Fibela/Mini-Sumo/Mini-Sumo/README.md

# Mini-Sumo
Lista de materiales - código fuente - circuito - planos y diseño
