Fibela/Mini-Sumo/cad/vistas/MiniSumo_Chasis_vistas.png

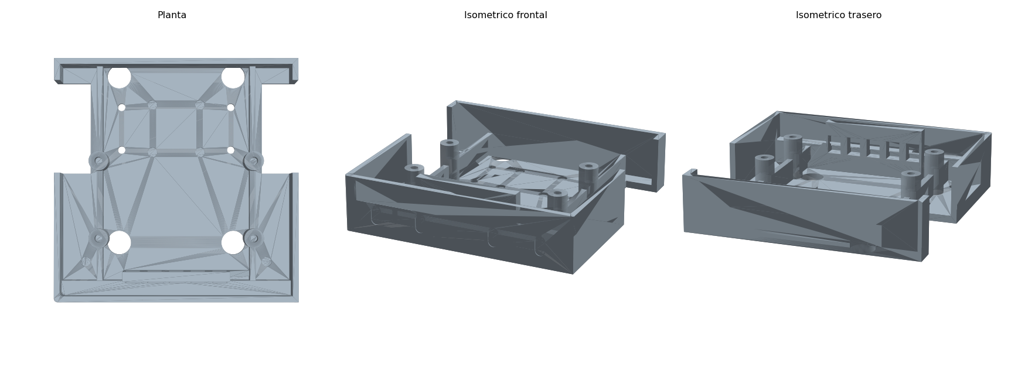
cad/vistas/MiniSumo_Chasis_vistas.png
