Fibela/Mini-Sumo/cad/vistas/MiniSumo_Cuna_Patin_vistas.png

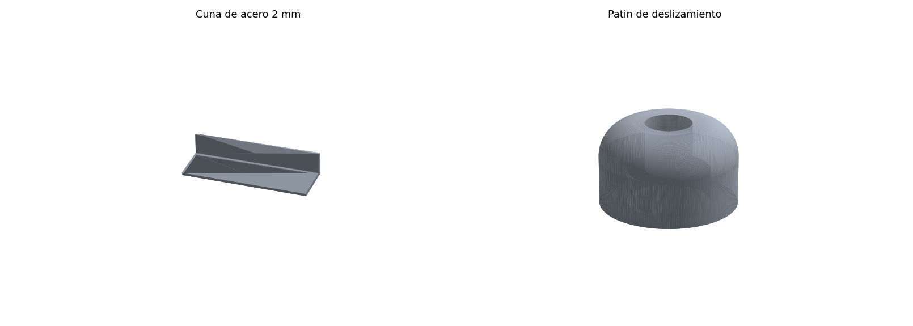
cad/vistas/MiniSumo_Cuna_Patin_vistas.png
