Fibela/Mini-Sumo/Mini-Sumo/lista-materiales.txt

Lista de materiales Sujeto a cambios

1° Arduino Nano ó ESP 32
2° LLantas de silicon(Fabricación propia) - Diametro 35 y 12 de ancho
3°  Puente H - L298N
4° Jumpers (x indefinido)
5° Sensores IR (x1) dedicado para bordes de dojo color blanco sustituyendo a los de linea por lo mientras
6° Batería LiPo 2S 850 mAh (x1)
7° Sensor de línea QRE1113 analógico (x4)
8° Motor D20 (x4)
9°  Cuña de acero 1mm 
10° sin Lastre
11° 5 sensores ToF VL53L1X
12° Display QLED 0.96 SSD1306 12C
