Fibela/Mini-Sumo/_revisar/MiniSumo_Chasis_2026-10-07.SLDPRT

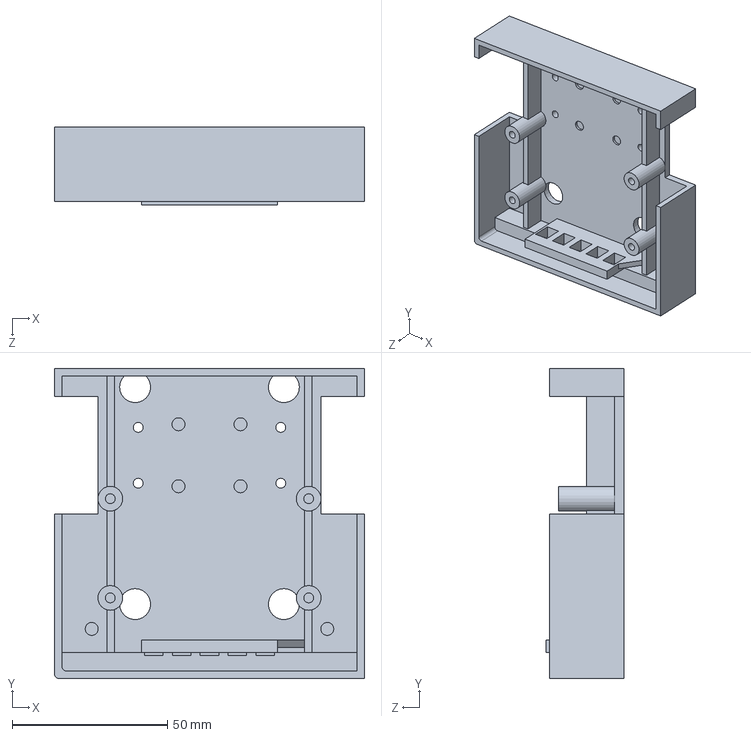
[picture p6: CAD file, 2026-10-07]
_revisar/MiniSumo_Chasis_2026-10-07.SLDPRT
100.0 x 100.0 x 25.0 mm
