Fibela/Mini-Sumo/cad/modelos/MiniSumo_Cuna_desarrollo_plano.step

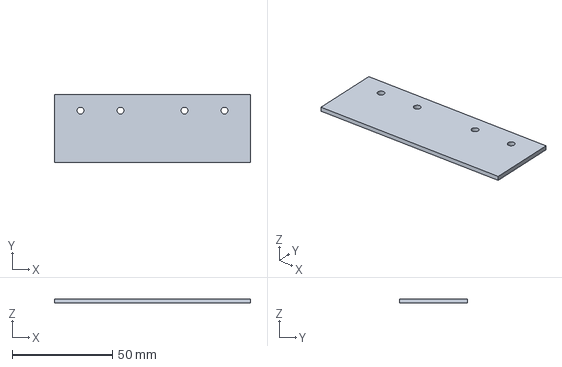
[picture p7: CAD file, 2026-10-07]
cad/modelos/MiniSumo_Cuna_desarrollo_plano.step
98.0 x 33.8 x 2.00 mm
