Fibela/Mini-Sumo/_revisar/Pieza1_2026-10-07.SLDPRT

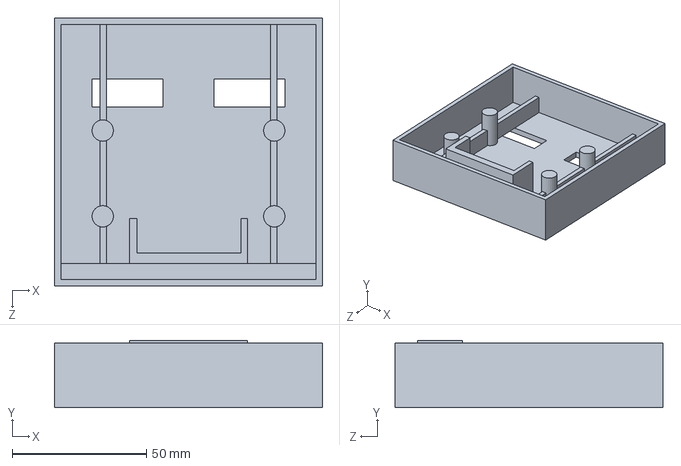
[picture p9: CAD file, 2026-10-07]
_revisar/Pieza1_2026-10-07.SLDPRT
100.0 x 25.0 x 100.0 mm
