Fibela/Mini-Sumo/cad/modelos/MiniSumo_Cuna_acero_2mm.step

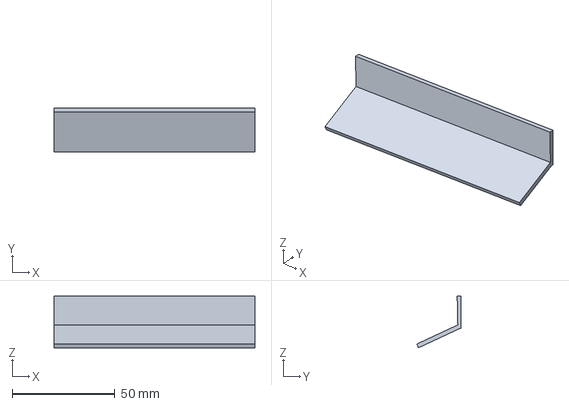
[picture p10: CAD file, 2026-10-07]
cad/modelos/MiniSumo_Cuna_acero_2mm.step
98.0 x 21.7 x 25.1 mm
