Fibela/Mini-Sumo/cad/modelos/MiniSumo_Separador_0p4mm.stl

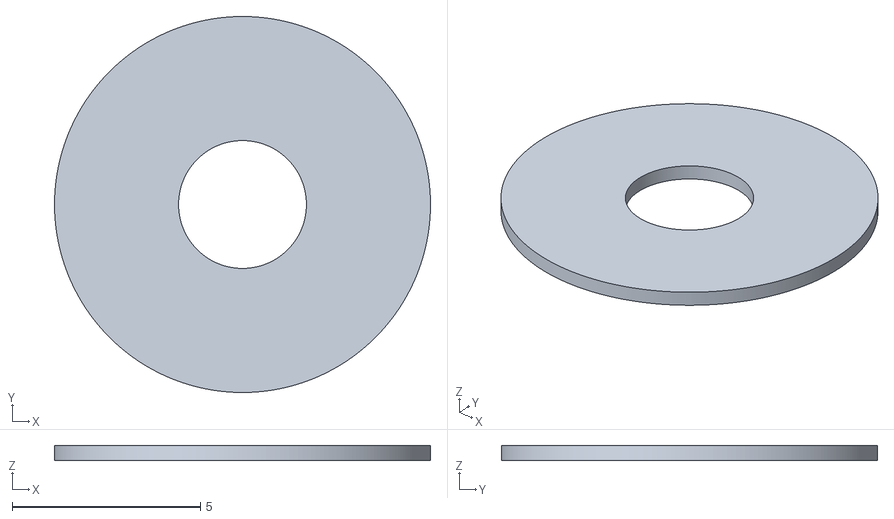
[picture p11: CAD file, 2026-10-07]
cad/modelos/MiniSumo_Separador_0p4mm.stl
10.0 x 10.0 x 0.4
