Fibela/Mini-Sumo/cad/modelos/MiniSumo_Patin.step

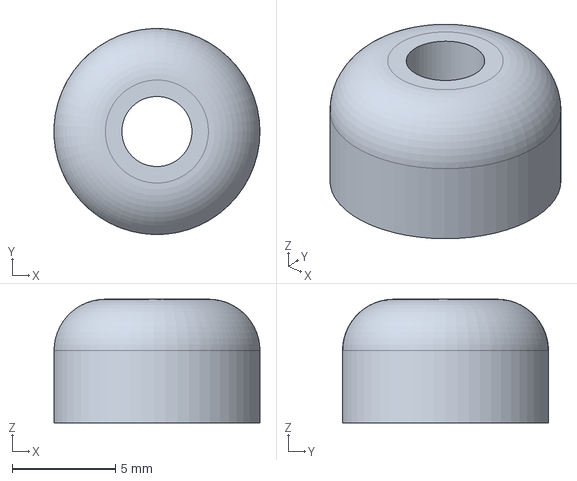
[picture p12: CAD file, 2026-10-07]
cad/modelos/MiniSumo_Patin.step
9.99 x 10.00 x 6.00 mm
