Fibela/Mini-Sumo/cad/modelos/MiniSumo_Separador_0p8mm.stl

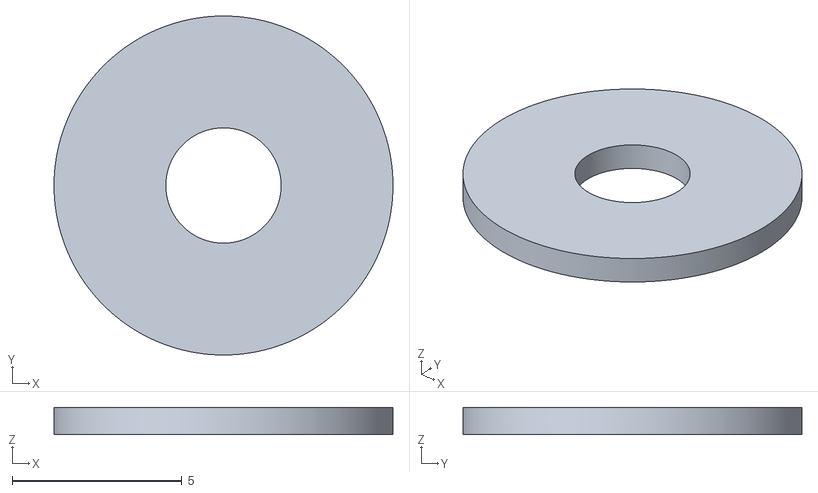
[picture p13: CAD file, 2026-10-07]
cad/modelos/MiniSumo_Separador_0p8mm.stl
10.0 x 10.0 x 0.8
