Fibela/Mini-Sumo/cad/modelos/MiniSumo_Separador_1p6mm.stl

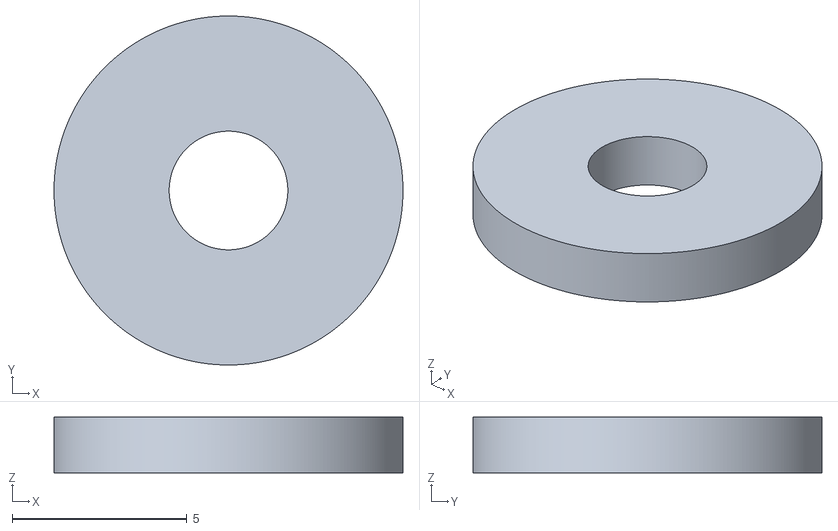
[picture p14: CAD file, 2026-10-07]
cad/modelos/MiniSumo_Separador_1p6mm.stl
10.0 x 10.0 x 1.60
