Fibela/Mini-Sumo/(list of files, cad)

Other CAD files:
cad/impresion/Chasis_RevB_v1.3mf
cad/impresion/Chasis_RevB_v2.3mf
cad/modelos/MiniSumo_Chasis.step
cad/modelos/MiniSumo_Chasis_RevB.SLDPRT
cad/impresion/Chasis_RevB_v1.stl
cad/modelos/MiniSumo_Chasis.stl
cad/modelos/MiniSumo_Cuna_acero_2mm.stl
cad/modelos/MiniSumo_Cuna_desarrollo_plano.dxf
cad/modelos/MiniSumo_Patin.stl
