Fibela/Mini-Sumo/docs/imagenes/montaje_fisico_placa_madre.png

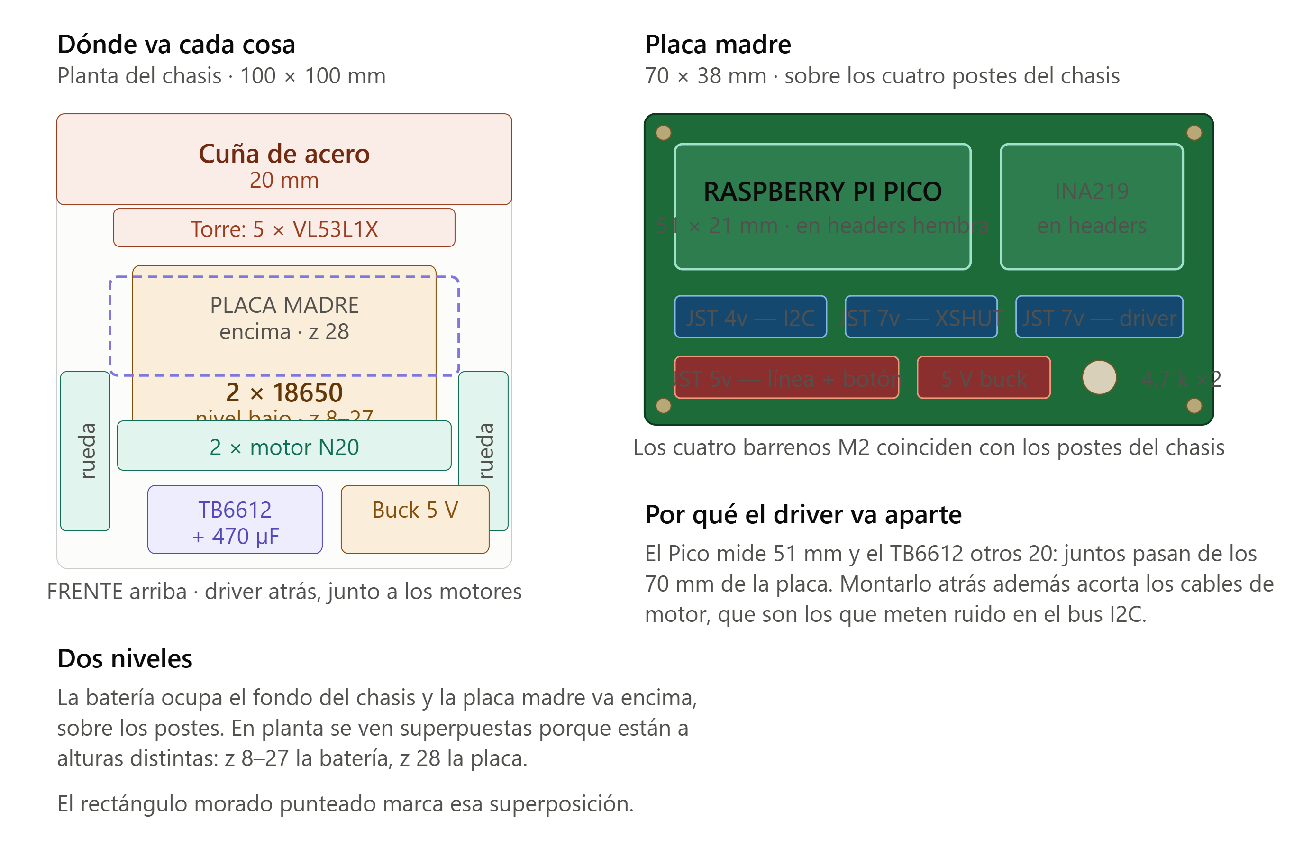
docs/imagenes/montaje_fisico_placa_madre.png
