Fibela/Mini-Sumo/MiniSumo_Planos.pdf

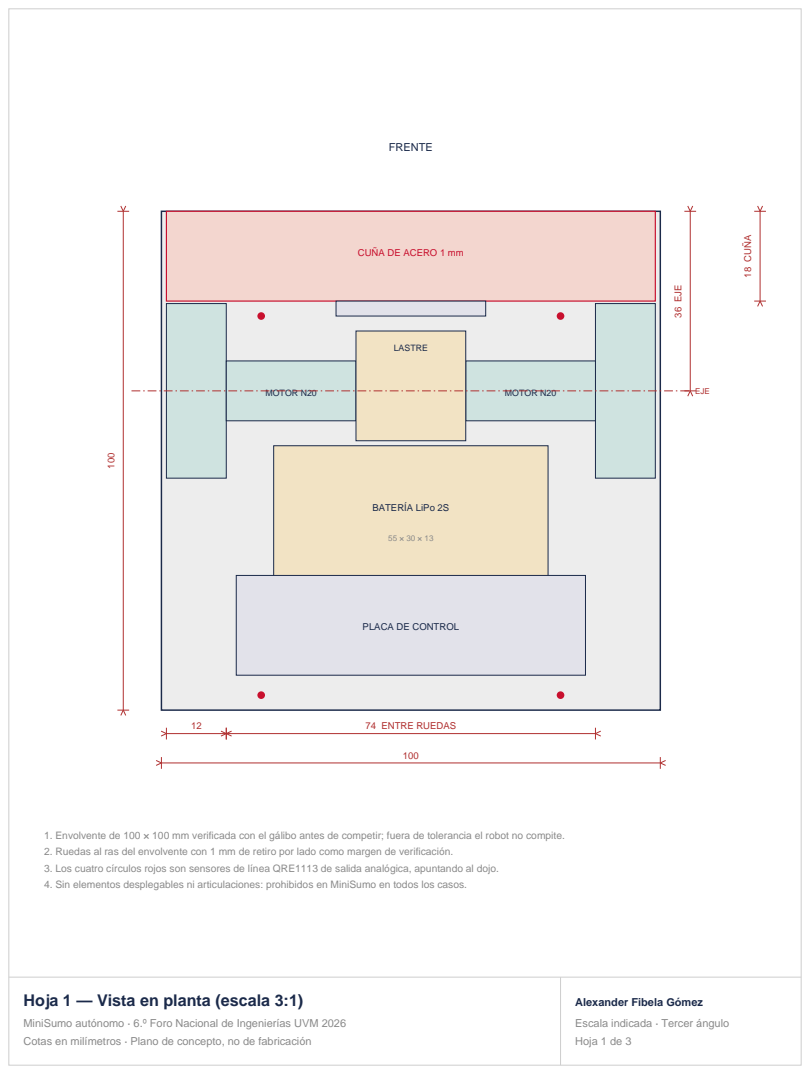
[picture p17: page 1]
MOTOR N20; LASTRE; BATERÍA LiPo 2S; EJE; 36 EJE; 18 CUÑA; 74 ENTRE RUEDAS; FRENTE

CUÑA DE ACERO 1 mm

PLACA DE CONTROL

1. Envolvente de 100 × 100 mm verificada con el gálibo antes de competir; fuera de tolerancia el robot no compite.
2. Ruedas al ras del envolvente con 1 mm de retiro por lado como margen de verificación.
3. Los cuatro círculos rojos son sensores de línea QRE1113 de salida analógica, apuntando al dojo.
4. Sin elementos desplegables ni articulaciones: prohibidos en MiniSumo en todos los casos.

Hoja 1 — Vista en planta (escala 3:1)

Alexander Fibela Gómez
Escala indicada · Tercer ángulo
Hoja 1 de 3

MiniSumo autónomo · 6.º Foro Nacional de Ingenierías UVM 2026
Cotas en milímetros · Plano de concepto, no de fabricación

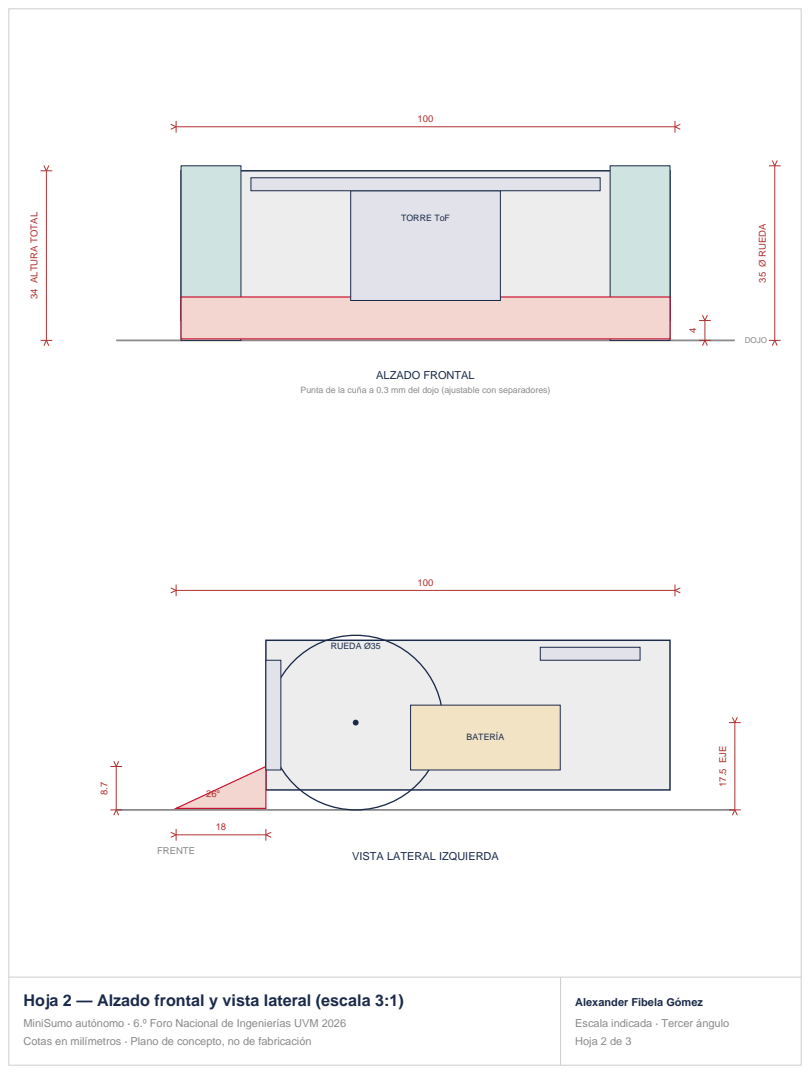
[picture p18: page 2]
DOJO; TORRE ToF; 34 ALTURA TOTAL; 35 Ø RUEDA; ALZADO FRONTAL; RUEDA Ø35; BATERÍA; 17.5 EJE

Punta de la cuña a 0.3 mm del dojo (ajustable con separadores)

VISTA LATERAL IZQUIERDA FRENTE

Hoja 2 — Alzado frontal y vista lateral (escala 3:1)

Alexander Fibela Gómez

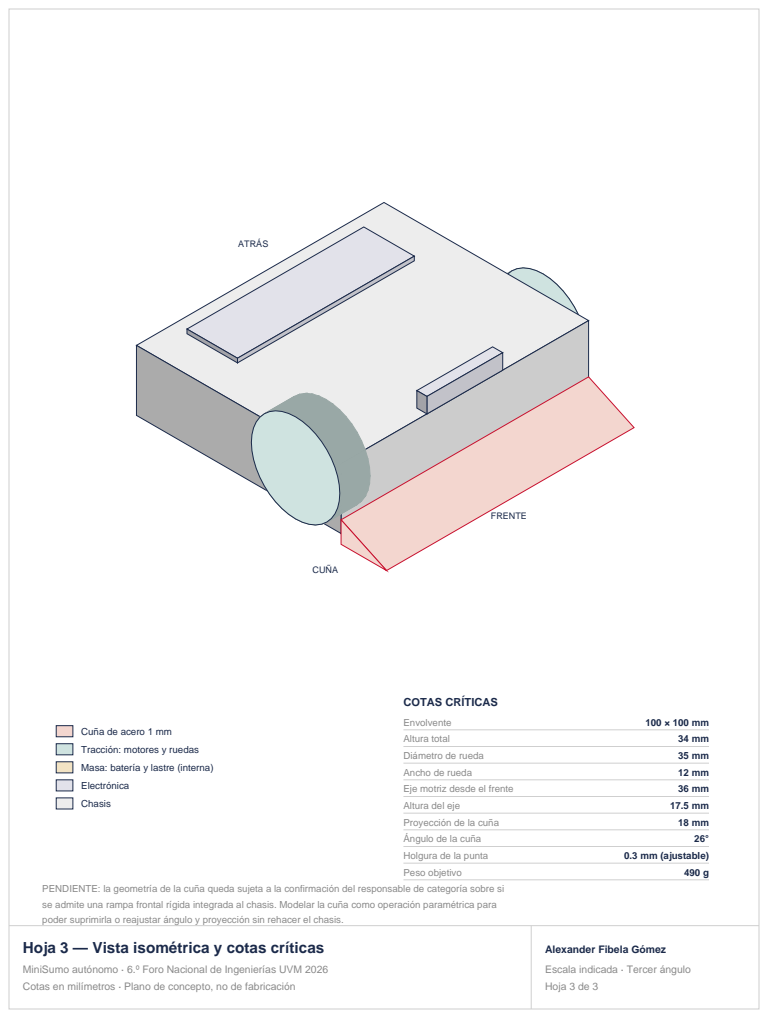
[picture p19: page 3]
CUÑA; ATRÁS; FRENTE; COTAS CRÍTICAS; Envolvente; Altura total; Diámetro de rueda; Ancho de rueda; Eje motriz desde el frente; Altura del eje; Proyección de la cuña; Ángulo de la cuña; Holgura de la punta; 0.3 mm (ajustable); Peso objetivo

Cuña de acero 1 mm
Tracción: motores y ruedas
Masa: batería y lastre (interna)
Electrónica
Chasis

PENDIENTE: la geometría de la cuña queda sujeta a la confirmación del responsable de categoría sobre si
se admite una rampa frontal rígida integrada al chasis. Modelar la cuña como operación paramétrica para
poder suprimirla o reajustar ángulo y proyección sin rehacer el chasis.
Hoja 3 — Vista isométrica y cotas críticas

Alexander Fibela Gómez
