Fibela/Mini-Sumo/docs/pdf/Planos_RevB_traccion_trasera.pdf

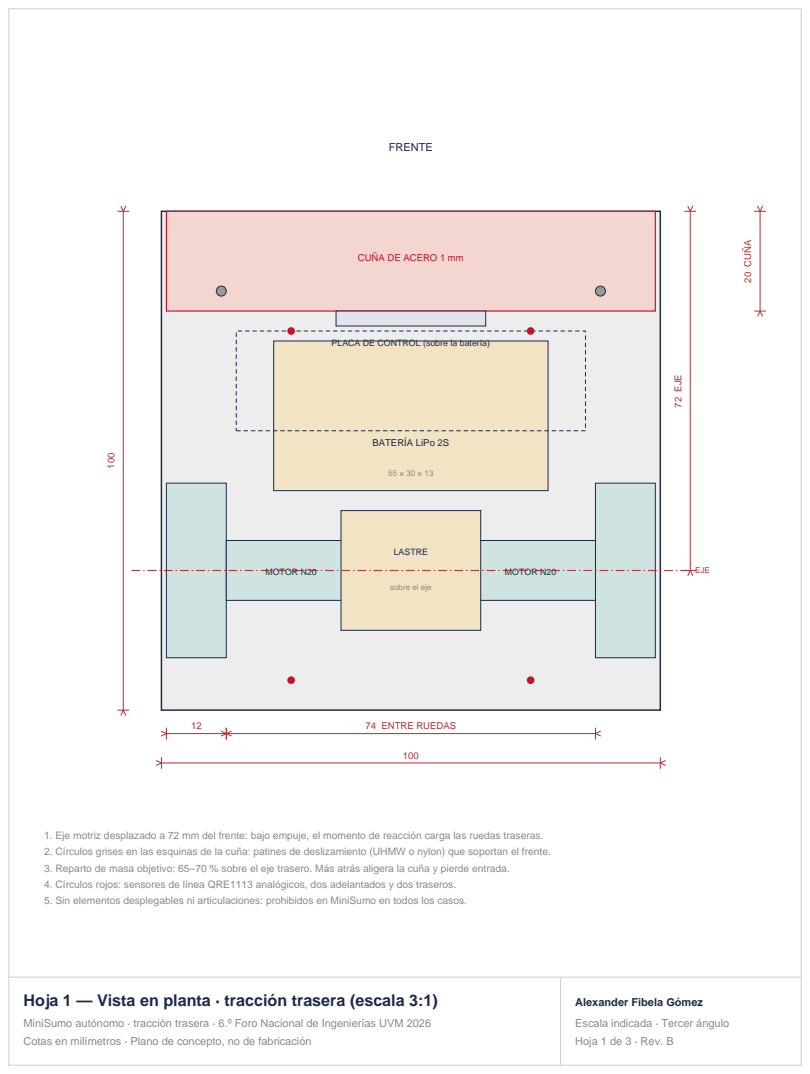
[picture p20: page 1]
MOTOR N20; LASTRE; BATERÍA LiPo 2S; EJE; 72 EJE; 20 CUÑA; 74 ENTRE RUEDAS; FRENTE

CUÑA DE ACERO 1 mm

PLACA DE CONTROL (sobre la batería)

sobre el eje

1. Eje motriz desplazado a 72 mm del frente: bajo empuje, el momento de reacción carga las ruedas traseras.
2. Círculos grises en las esquinas de la cuña: patines de deslizamiento (UHMW o nylon) que soportan el frente.
3. Reparto de masa objetivo: 65–70 % sobre el eje trasero. Más atrás aligera la cuña y pierde entrada.
4. Círculos rojos: sensores de línea QRE1113 analógicos, dos adelantados y dos traseros.
5. Sin elementos desplegables ni articulaciones: prohibidos en MiniSumo en todos los casos.

Hoja 1 — Vista en planta · tracción trasera (escala 3:1)

Alexander Fibela Gómez
Escala indicada · Tercer ángulo
Hoja 1 de 3 · Rev. B

MiniSumo autónomo · tracción trasera · 6.º Foro Nacional de Ingenierías UVM 2026
Cotas en milímetros · Plano de concepto, no de fabricación

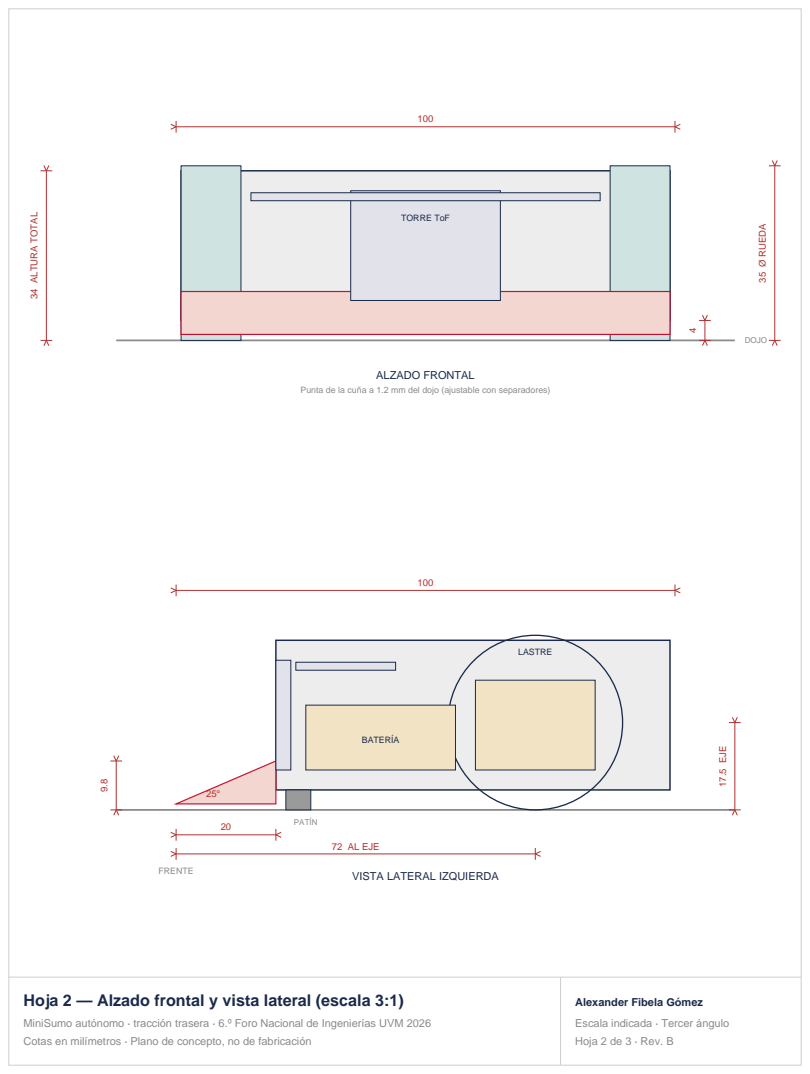
[picture p21: page 2]
DOJO; TORRE ToF; 34 ALTURA TOTAL; 35 Ø RUEDA; ALZADO FRONTAL; PATÍN; BATERÍA; LASTRE; 72 AL EJE; 17.5 EJE

Punta de la cuña a 1.2 mm del dojo (ajustable con separadores)

VISTA LATERAL IZQUIERDA FRENTE

Hoja 2 — Alzado frontal y vista lateral (escala 3:1)

Alexander Fibela Gómez

Hoja 2 de 3 · Rev. B

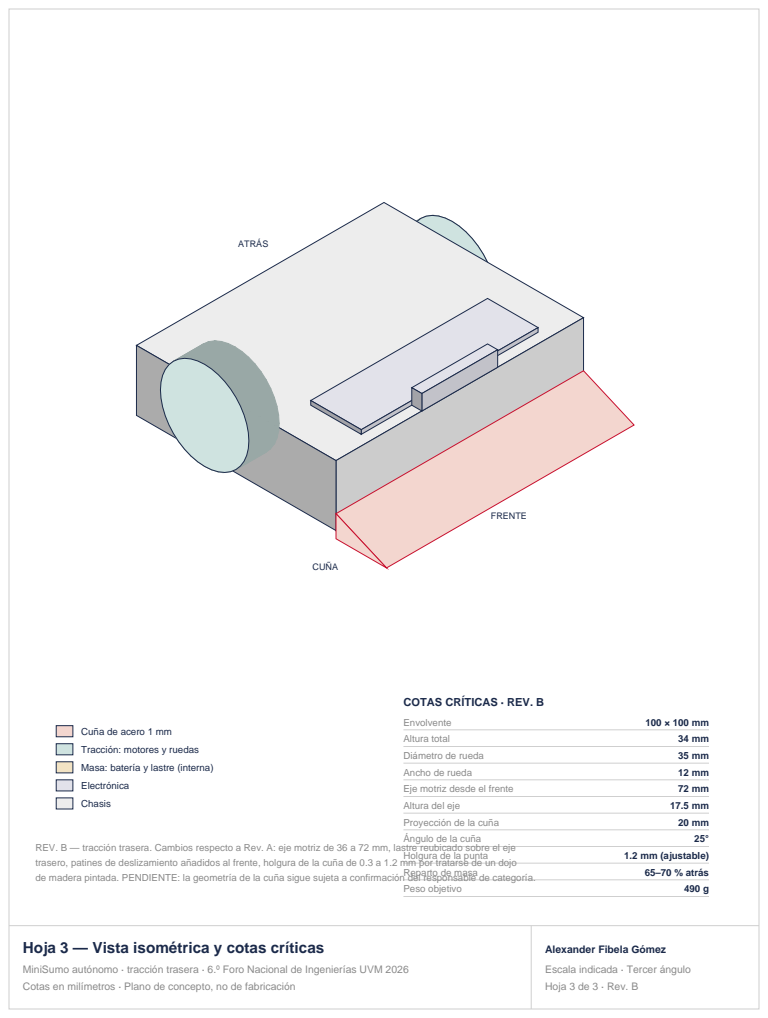
[picture p22: page 3]
CUÑA; ATRÁS; FRENTE; Envolvente; Altura total; Diámetro de rueda; Ancho de rueda; Eje motriz desde el frente; Altura del eje; Proyección de la cuña; Ángulo de la cuña; Holgura de la punta; 1.2 mm (ajustable); Reparto de masa; 65–70 % atrás; Peso objetivo

COTAS CRÍTICAS · REV. B

Cuña de acero 1 mm
Tracción: motores y ruedas
Masa: batería y lastre (interna)
Electrónica
Chasis

REV. B — tracción trasera. Cambios respecto a Rev. A: eje motriz de 36 a 72 mm, lastre reubicado sobre el eje
trasero, patines de deslizamiento añadidos al frente, holgura de la cuña de 0.3 a 1.2 mm por tratarse de un dojo
de madera pintada. PENDIENTE: la geometría de la cuña sigue sujeta a confirmación del responsable de categoría.

Hoja 3 — Vista isométrica y cotas críticas

Alexander Fibela Gómez

Hoja 3 de 3 · Rev. B
