Fibela/Mini-Sumo/(commit log)

2026-10-01 Primer Push, lista de materiales, planos y todo sujeto a cambios
2026-10-01 Agregar lista de materiales y README como archivos normales
2026-10-01 Firmware ESP32 v0.1 con pruebas en display OLED (sujeto a cambios)
    Primera versión del firmware del Mini Sumo para ESP32. Compila sin
    errores ni avisos, pero AÚN NO SE HA PROBADO EN LA PLACA: pines,
    umbrales y tiempos están sujetos a cambios después de las pruebas
    físicas y de confirmar el funcionamiento del hardware.
    Especificaciones de hardware
    - Controlador: ESP32 DevKit V1 (sustituye al Arduino Nano de la lista)
    - Puente H: L298N, PWM a 1 kHz / 8 bits (ENA y ENB sin jumper)
    - Motores: 4x D20, 2 en paralelo por canal (izquierdo / derecho)
    - Línea: 4x QRE1113 analógicos (DI, DD, TI, TD) en ADC1
    - Oponente: 1x Sharp GP2Y0A21 analógico al frente
    - Display: OLED 0.96" SSD1306 I2C (0x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
    [MiniSumo_ESP32.ino, config.h]
2026-10-07 Modelo CAD del chasis Rev. B con traccion trasera
    Anade la geometria fabricable del minisumo: chasis impreso, cuna de
    acero y patines de deslizamiento, con sus fuentes parametricas.
    cad/modelos
    - MiniSumo_Chasis_RevB.SLDPRT: pieza nativa con arbol parametrico y
    ecuaciones globales. Envolvente 100 x 100 x 25 mm, 58 g en PETG
    - STEP y STL de chasis, cuna y patines, mas separadores de calibracion
    - MiniSumo_Cuna_desarrollo_plano.dxf: desarrollo para corte laser,
    98 x 33.85 mm con el factor de doblez ya calculado
    cad/macros
    - MiniSumo_Chasis_v2.bas: reconstruye el chasis completo en SolidWorks
    y guarda la pieza al terminar
    cad/scripts
    - Modelos en CadQuery, fuente de los STEP y STL
    Dec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
    [MiniSumo_Chasis.step, MiniSumo_Chasis.stl, MiniSumo_Chasis_RevB.SLDPRT, MiniSumo_Cuna_acero_2mm.step, MiniSumo_Cuna_acero_2mm.stl, MiniSumo_Cuna_desarrollo_plano.dxf, MiniSumo_Cuna_desarrollo_plano.step, MiniSumo_Patin.step]
2026-10-07 Firmware v0.2: sensores intercambiables y robustez frente al rival
    Adapta el firmware a los planos Rev B (tracción trasera) y lo hace
    independiente del modelo de sensor y del equipo del rival. Compila sin
    errores ni avisos en las 8 combinaciones de sensores, pero AÚN NO SE HA
    PROBADO EN LA PLACA: sujeto a cambios tras las pruebas físicas.
    Sensores intercambiables (config.h)
    - SENSOR_OPONENTE: SENSOR_SHARP (por defecto), SENSOR_DIGITAL,
    SENSOR_VL53L0X o SENSOR_VL53L1X. Los ToF van por I2C (0x29) en el
    mismo bus que el OLED (21/22), en modo continuo cada 20 ms y leídos
    sin bloquear el bucle de pelea. Umbral en mm: DISTANCIA_ATAQUE_MM.
    - LINEA_DIGITAL: sensores de línea analógicos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
    [MiniSumo_ESP32.ino, config.h]
2026-10-07 Lista de materiales actualizada, propuesta de mejoras y piezas CAD
    Lista de materiales (sujeta a cambios)
    - Controlador: Arduino Nano o ESP32
    - Llantas de silicón de fabricación propia: ø35 x 12 mm
    - Puente H: L298N
    - Sensor IR (x1) dedicado al borde blanco del dojo, provisional en
    lugar de los sensores de línea
    - Batería LiPo 2S 850 mAh (se retira la opción Energizer)
    - Cuña de acero de 1 mm, sin lastre
    - 5 sensores ToF VL53L1X
    - Display OLED 0.96" SSD1306 I2C
    Documentos y modelos
    - MiniSumo_Propuesta_Mejoras.pdf: revisión de la lista de materiales.
    Propone 2 TB6612FNG en lugar del L298N, placa base de aluminio,
    cuña de 2 mm, LiPo de 2200 mAh, ruedas de silicón blando y cab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
    [MiniSumo_Chasis.SLDPRT, Pieza1.1.SLDPRT, Pieza1.SLDPRT]
2026-10-07 Marcar PDF, CAD y archivos de impresión como binarios
    Evita que Git convierta los fines de línea de los PDF y modelos al
    descargarlos en Windows, lo que podría corromperlos.
2026-10-17 Documentar los componentes realmente comprados y las dos rutas de MCU
    La lista de materiales del repo describia un montaje que ya no existe:
    Arduino Nano o ESP32, L298N, LiPo de 850 mAh y cuatro motores. Lo que se
    compro el 12/10/2026 es otra cosa. Este commit alinea la documentacion
    con el hardware real.
    docs/componentes.md (nuevo)
    Que es cada componente, para que sirve, a que va conectado y como se
    conecta. Incluye los conceptos previos (GPIO, ADC, PWM, I2C, masa comun)
    y las dos trampas que mas tiempo hacen perder: la secuencia de XSHUT
    para reasignar las direcciones de los cinco VL53L1X, y los pull-ups
    duplicados del bus I2C.
    docs/conexiones.md (nuevo)
    Asignacion de pines para las do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
2026-10-17 Prueba 01 de sensores ToF y seleccion de switches y conectores
    firmware/pruebas/01_prueba_tof/
    Primer sketch del proyecto. Resuelve la secuencia de XSHUT: los cinco
    VL53L1X salen de fabrica en 0x29 y hay que despertarlos de uno en uno
    para reasignarles direccion. Es el problema que mas tiempo hace perder
    y el sintoma engaña, porque parece un error de codigo.
    El mismo archivo compila en Raspberry Pi Pico y en ESP32: los pines se
    eligen al compilar segun la placa seleccionada en el IDE.
    Comentado linea por linea, pensado para que cualquiera del equipo pueda
    seguirlo sin haber visto el resto del proyecto. Incluye que comprobar al
    ejecutarlo y como interpretar los fallos: si fallan siempre lo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
2026-10-17 Reorganizar el repositorio y añadir indice
    La raiz tenia doce archivos sueltos entre planos, PDFs, versiones
    intermedias de SolidWorks y archivos de laminado, mas una carpeta
    Mini-Sumo con la lista de materiales duplicada en .txt y .md. Encontrar
    algo exigia saber de antemano donde estaba.
    Estructura nueva: cuatro carpetas en la raiz, cada una con un proposito
    unico.
    docs/ documentacion, PDFs e imagenes
    cad/ diseno mecanico, incluida la carpeta de impresion
    firmware/ codigo de combate y sketches de prueba
    _revisar/ versiones intermedias, pendientes de depurar
    Movimientos principales
    - Los cinco PDFs de la raiz pasan a docs/pdf/ con nombres consistentes
    - list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
